CLOSUR1/2021_F_MEDScar/README.md

# 2021_F_MEDScar
2021年全国大学生电子设计大赛F题智能送药小车
