CLOSUR1/2021_F_MEDScar/流程图/openmv巡线.png

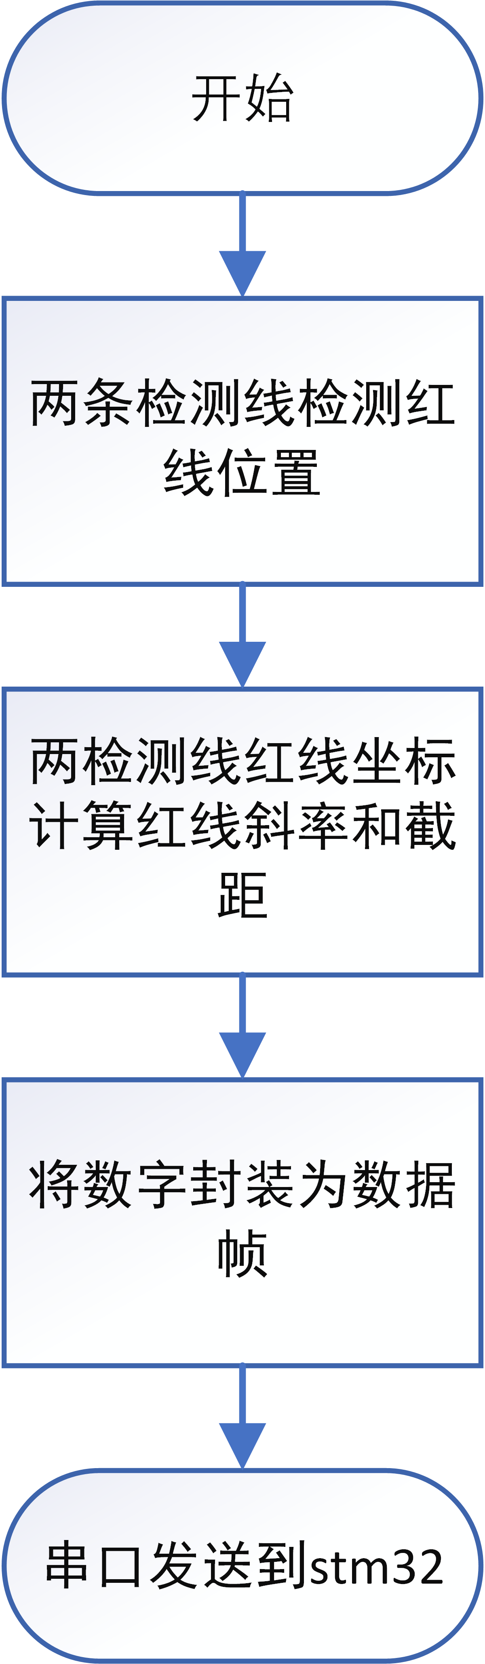
流程图/openmv巡线.png
