CLOSUR1/2021_F_MEDScar/流程图/openmv识别数字.png

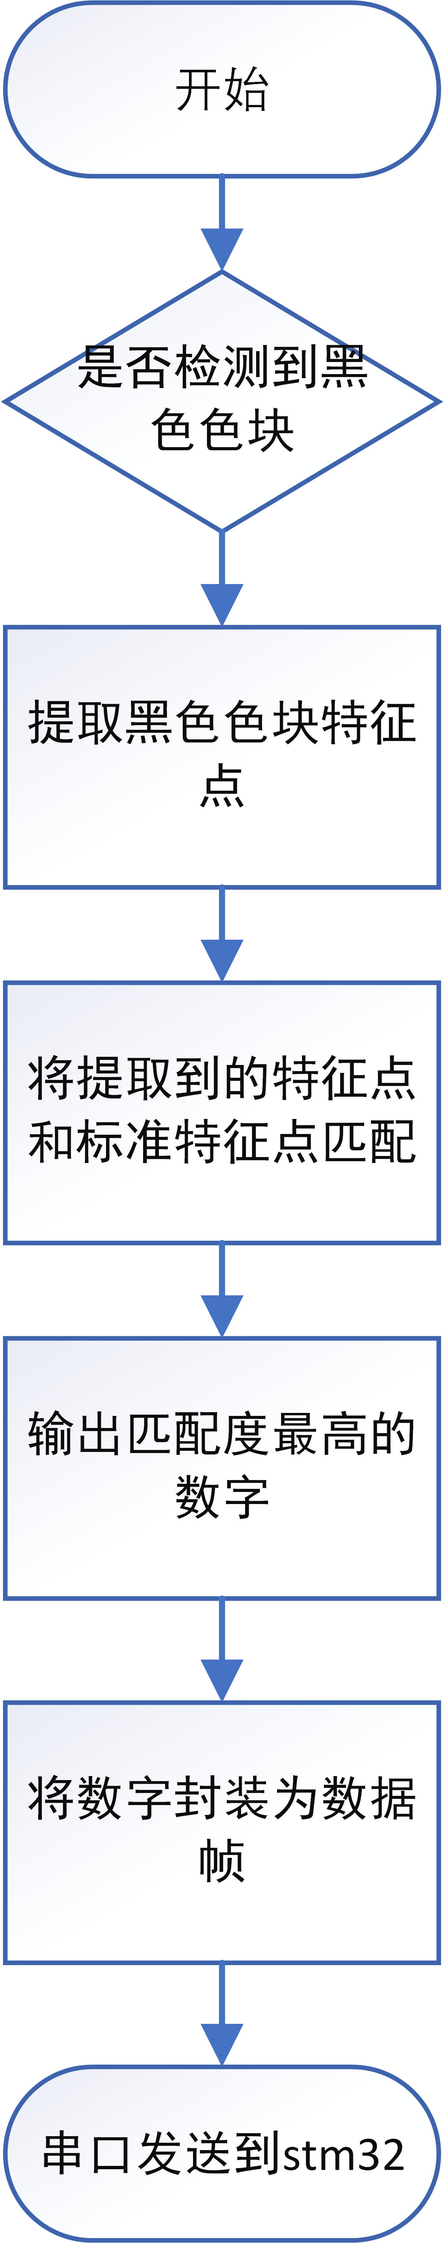
流程图/openmv识别数字.png
