CLOSUR1/2021_F_MEDScar/流程图/主程序.png

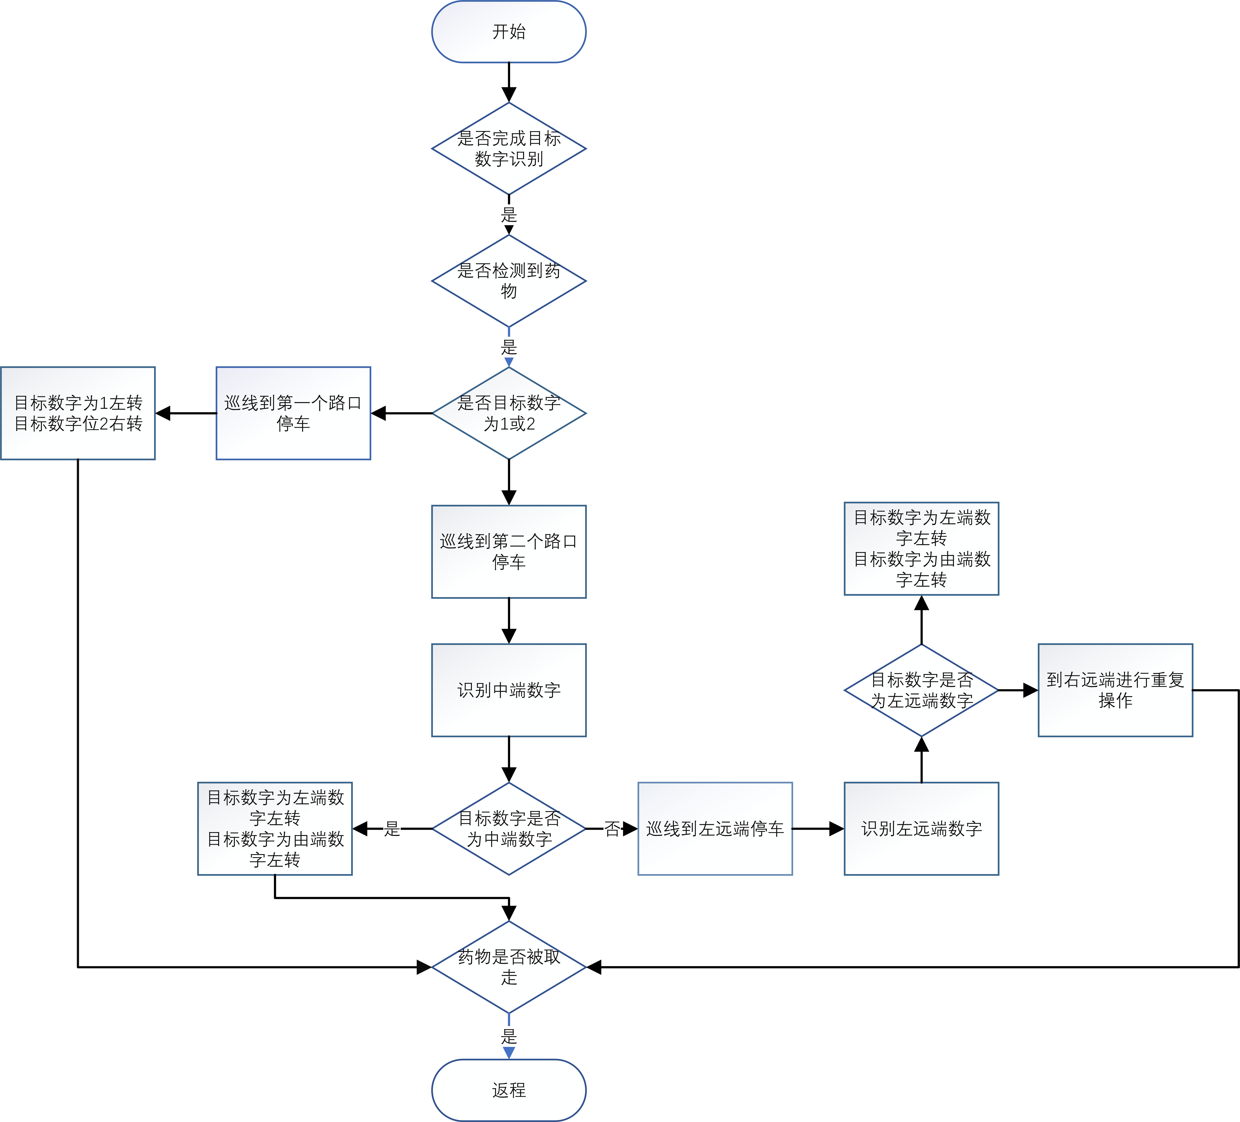
流程图/主程序.png
