CLOSUR1/2021_F_MEDScar/流程图/巡线PID.png

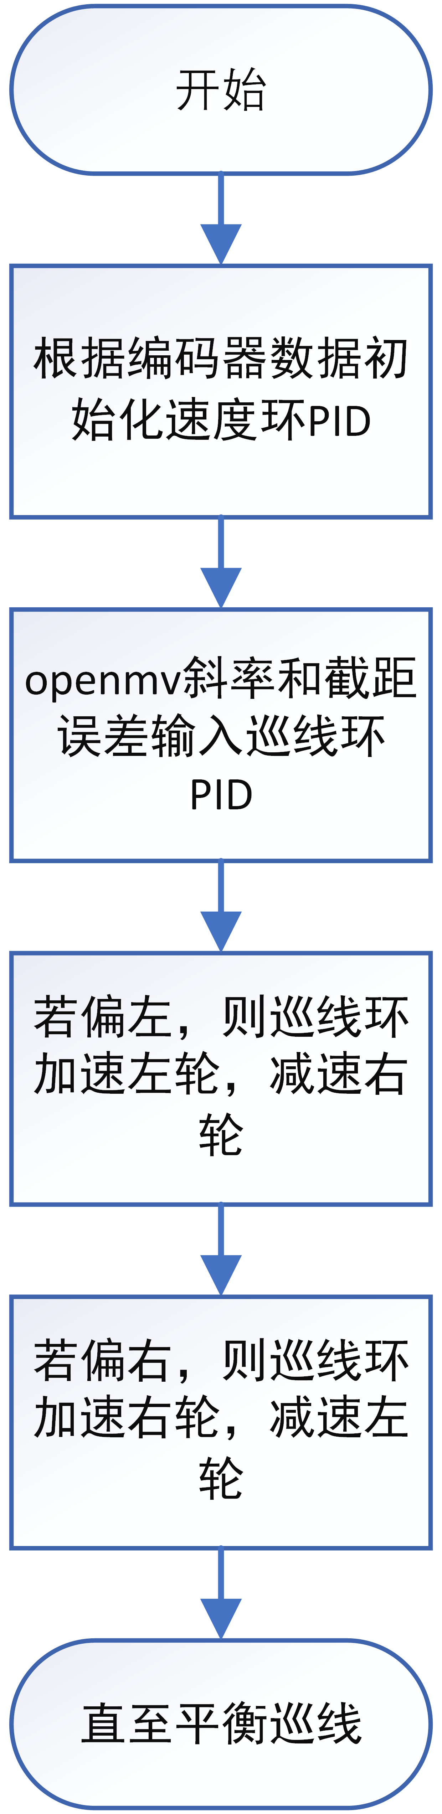
流程图/巡线PID.png
