CLOSUR1/2021_F_MEDScar/流程图/电机驱动.png

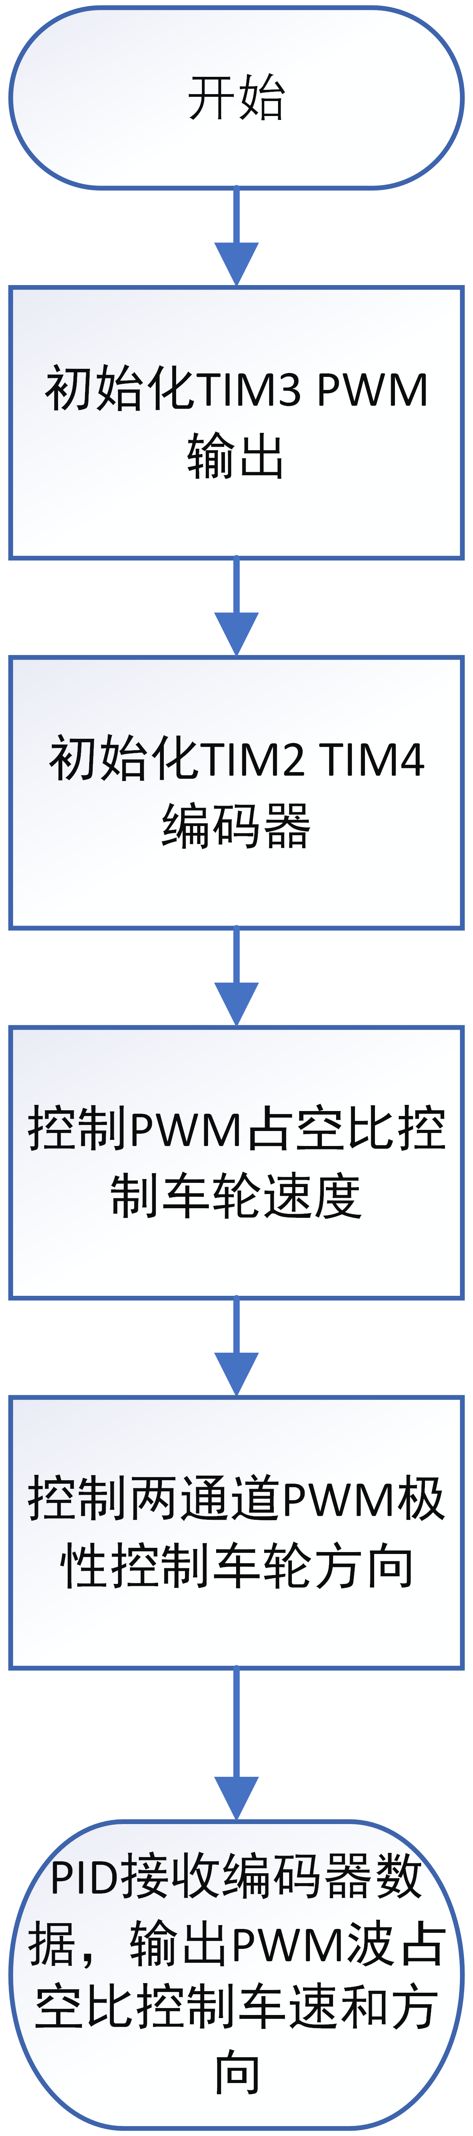
流程图/电机驱动.png
