CLOSUR1/2021_F_MEDScar/流程图/超声识别.png

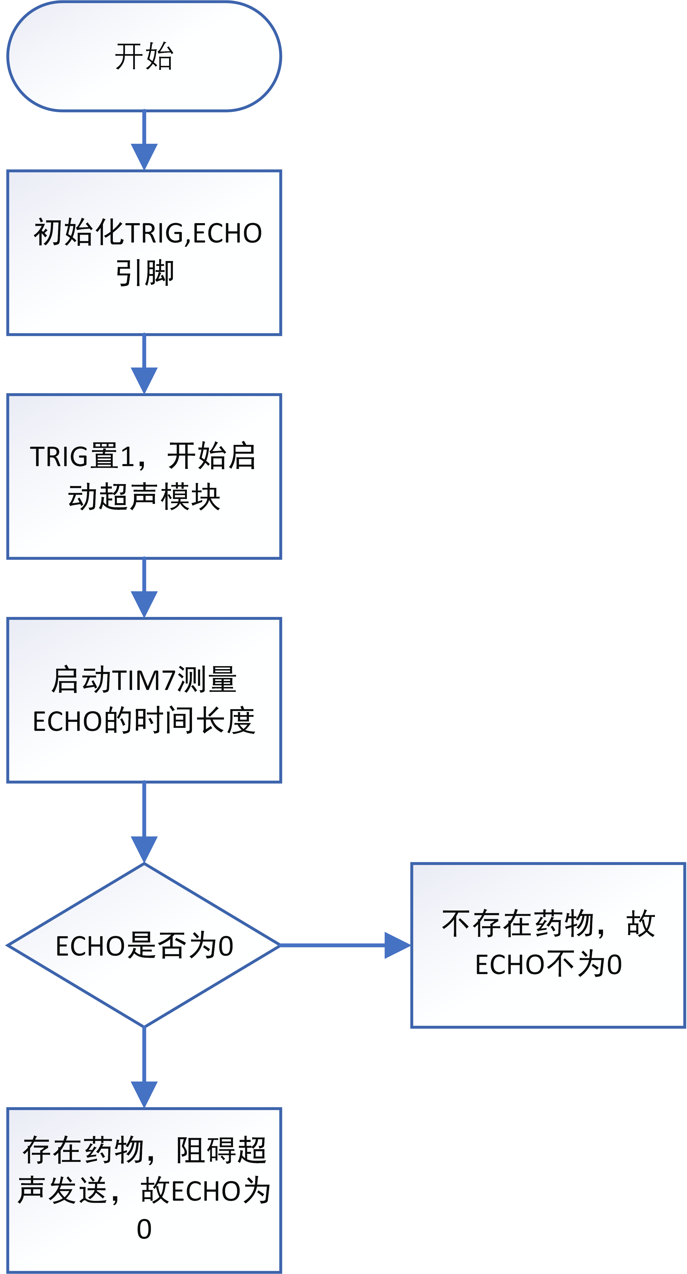
流程图/超声识别.png
