CLOSUR1/2021_F_MEDScar/(list of files, drawings)

Other design files:
PCB/上底板/PCB_上底板.pcbdoc
PCB/上底板/原理图_上底板.schdoc
PCB/车架/车架.pcbdoc
PCB/车架/车架.schdoc
PCB/车身/车身411.pcbdoc
PCB/车身/车身411.schdoc
