CLOSUR1/2021_F_MEDScar/代码合集/STM32F411主控/HARDWARE/LED/led.c

#include "led.h" 
#include "delay.h"

void LED_Init(void)
{    	 
  GPIO_InitTypeDef  GPIO_InitStructure;

  RCC_AHB1PeriphClockCmd(RCC_AHB1Periph_GPIOC, ENABLE);//使能GPIOF时钟

  GPIO_InitStructure.GPIO_Pin = GPIO_Pin_13;//LED0和LED1对应IO口
  GPIO_InitStructure.GPIO_Mode = GPIO_Mode_OUT;//普通输出模式
  GPIO_InitStructure.GPIO_OType = GPIO_OType_PP;//推挽输出
  GPIO_InitStructure.GPIO_Speed = GPIO_Speed_100MHz;//100MHz
  GPIO_InitStructure.GPIO_PuPd = GPIO_PuPd_UP;//上拉
  GPIO_Init(GPIOC, &GPIO_InitStructure);//初始化GPIO
	
	LED=0;
}


//void RGBLED_Init(void)
//{    	 
//  GPIO_InitTypeDef  GPIO_InitStructure;

//  RCC_AHB1PeriphClockCmd(RCC_AHB1Periph_GPIOC, ENABLE);//使能GPIOF时钟

//  GPIO_InitStructure.GPIO_Pin = GPIO_Pin_14|GPIO_Pin_15;//LED0和LED1对应IO口
//  GPIO_InitStructure.GPIO_Mode = GPIO_Mode_OUT;//普通输出模式
//  GPIO_InitStructure.GPIO_OType = GPIO_OType_PP;//推挽输出
//  GPIO_InitStructure.GPIO_Speed = GPIO_Speed_100MHz;//100MHz
//  GPIO_InitStructure.GPIO_PuPd = GPIO_PuPd_UP;//上拉
//  GPIO_Init(GPIOC, &GPIO_InitStructure);//初始化GPIO
//	
//	GLED=1;
//	RLED=0;
//}


void RGBLED_Init(void)
{    	 
  GPIO_InitTypeDef  GPIO_InitStructure;

  RCC_AHB1PeriphClockCmd(RCC_AHB1Periph_GPIOB, ENABLE);//使能GPIOB时钟

  GPIO_InitStructure.GPIO_Pin = GPIO_Pin_12|GPIO_Pin_13;//LED0和LED1对应IO口
  GPIO_InitStructure.GPIO_Mode = GPIO_Mode_OUT;//普通输出模式
  GPIO_InitStructure.GPIO_OType = GPIO_OType_PP;//推挽输出
  GPIO_InitStructure.GPIO_Speed = GPIO_Speed_100MHz;//100MHz
  GPIO_InitStructure.GPIO_PuPd = GPIO_PuPd_UP;//上拉
  GPIO_Init(GPIOB, &GPIO_InitStructure);//初始化GPIO
	
	GLED=1;
	RLED=0;
}



void BEEP_Init(void)
{
	 GPIO_InitTypeDef  GPIO_InitStructure;

  RCC_AHB1PeriphClockCmd(RCC_AHB1Periph_GPIOB, ENABLE);//使能GPIOF时钟

  GPIO_InitStructure.GPIO_Pin = GPIO_Pin_13;//LED0和LED1对应IO口
  GPIO_InitStructure.GPIO_Mode = GPIO_Mode_OUT;//普通输出模式
  GPIO_InitStructure.GPIO_OType = GPIO_OType_PP;//推挽输出
  GPIO_InitStructure.GPIO_Speed = GPIO_Speed_100MHz;//100MHz
  GPIO_InitStructure.GPIO_PuPd = GPIO_PuPd_UP;//上拉
  GPIO_Init(GPIOB, &GPIO_InitStructure);//初始化GPIO
	
	BEEP=0;
	
}




void LED_Flightblink(void)
{
	   LED=0;			  //LED0亮

		 delay_ms(500);
		 LED=1;				//LED0灭

		 delay_ms(500);
        
        
     LED=0;			  //LED0亮

		 delay_ms(50);
		 LED=1;				//LED0灭

		 delay_ms(50);
     LED=0;			  //LED0亮

		 delay_ms(50);
	
		 LED=1;				//LED0灭

		 delay_ms(50);
	
}
