CLOSUR1/2021_F_MEDScar/代码合集/STM32F411主控/USER/hcsr.c

#include "hcsr.h"
#include "syslib.h"

#define TRIG PBout(8)
#define ECHO PAin(5)

void HW_Init(void)
{
	GPIO_InitTypeDef GPIO_InitStruct;
	RCC_AHB1PeriphClockCmd(RCC_AHB1Periph_GPIOA,ENABLE);

	GPIO_InitStruct.GPIO_Speed	= GPIO_Speed_50MHz;			
	GPIO_InitStruct.GPIO_Pin	= GPIO_Pin_5;			
	GPIO_InitStruct.GPIO_Mode	= GPIO_Mode_IN;				
	GPIO_InitStruct.GPIO_PuPd	= GPIO_PuPd_DOWN;		
	GPIO_Init(GPIOA, &GPIO_InitStruct);	
}

void PUT_TEST_HW(void)
{
	int count1=0;
	int n=3;
	if(PUT_TEST_FLAG==1)
	{
		for (int i=0;i<n;i++)
		{
			if(ECHO==1) count1++;
//			printfloat(ECHO);
			delay_ms(100);
		}
	
		if(PUT_TARGET==1)
		{
			if(count1==n) PUT_FLAG=1;
		}
		
		if(PUT_TARGET==0)
		{
			if(count1==0) PUT_FLAG=0;
		}
	}
	else if(PUT_TEST_FLAG==0)
	{
		PUT_FLAG=2;
	}
}

void HCSR_Init(void)
{
	
	GPIO_InitTypeDef GPIO_InitStruct;
	RCC_AHB1PeriphClockCmd(RCC_AHB1Periph_GPIOB,ENABLE);

	GPIO_InitStruct.GPIO_Pin	= GPIO_Pin_8;			
	GPIO_InitStruct.GPIO_Mode	= GPIO_Mode_OUT;		
	GPIO_InitStruct.GPIO_OType	= GPIO_OType_PP;	
	GPIO_InitStruct.GPIO_Speed	= GPIO_Speed_50MHz;		
	GPIO_InitStruct.GPIO_PuPd	= GPIO_PuPd_UP;
	GPIO_Init(GPIOB, &GPIO_InitStruct);
	
	GPIO_InitStruct.GPIO_Pin	= GPIO_Pin_9;			
	GPIO_InitStruct.GPIO_Mode	= GPIO_Mode_IN;				
	GPIO_InitStruct.GPIO_PuPd	= GPIO_PuPd_NOPULL;		
	GPIO_Init(GPIOB, &GPIO_InitStruct);	

	TIM11_IRQ_Init(0.1);
}

int HCSR_GetDis(void)
{
	int t = 0;
	int distance;
	int count = 0;
	
	TRIG=0;
	delay_us(5);
	TRIG=1;
	delay_us(10);
	TRIG=0;

	TIM11->CNT = 0;
	
	while( ECHO == 0)
	{
		t++;
//		delay_us(10);
	
		if(t>= 50000*3)
			return 0;
	}

	TIM_Cmd(TIM11, ENABLE);	
	
	t=0;

	while(ECHO== 1)
	{
		t++;
//		delay_us(20);
	
		if(t >= 120000*3)
			return 0;		
	}

	count = TIM11->CNT;
	
	TIM_Cmd(TIM11, DISABLE);	
	
	distance = count/1;

	return distance;

}

int PUT_FLAG=0;
int PUT_TEST_FLAG=0;
int PUT_TARGET=2;
int d[10];

int sq(int a[],int n) //相似数检测，当有药物时，数据为±3以内波动的数列
{
	int sq=0;
	for (int i=0;i<n;i++)
	{
		if(a[0]-a[i]>=-1&&a[0]-a[i]<=1)
			sq++;
	}
	return sq;
}

int K[3];
void PUT_TEST(void)
{
	int n=5;
	if(PUT_TEST_FLAG==1)
	{
		for (int i=0;i<n;i++)
		{
			int len=HCSR_GetDis();
			d[i]=len;
			delay_ms(100);
			printfloat(len);
		}
		
		K[2]=K[1]; //轮询检测三次
		K[1]=K[0];
		K[0]=sq(d,n);

//		printfloat(K[0]);
		if(PUT_TARGET==1)
		{
			if(K[0]==n&&K[1]==n&&K[2]==n) PUT_FLAG=1;
		}
		
		if(PUT_TARGET==0)
		{
			if(K[0]!=n&&K[1]!=n&&K[2]!=n&&K[0]!=0&&K[1]!=0&&K[2]!=0) PUT_FLAG=0;
		}
	}
	else if(PUT_TEST_FLAG==0)
	{
		PUT_FLAG=2;
		K[2]=0;
		K[1]=0;
		K[0]=0;
	}
}

void HCSR_TEST(void)
{
	PUT_TEST_FLAG=1;
	PUT_TEST();
	if(PUT_FLAG==PUT_TARGET){ GLED=PUT_TARGET;PUT_TARGET=~PUT_TARGET;}
}

void TIM11_IRQ_CallBack(void)
{
	
}


void TIM1_TRG_COM_TIM11_IRQHandler(void)   //TIM11中断
{
	if (TIM_GetITStatus(TIM11, TIM_IT_Update) != RESET)  
		{
		  TIM_ClearITPendingBit(TIM11, TIM_IT_Update); 
			TIM11_IRQ_CallBack();	     
	  }
}

void TIM11_IRQ_Init(float TT)
{
  TIM_TimeBaseInitTypeDef  TIM_TimeBaseStructure;

	RCC_APB2PeriphClockCmd(RCC_APB2Periph_TIM11, ENABLE); //时钟使能
	
	//定时器TIM11初始化
	TIM_TimeBaseStructure.TIM_Period = TT*1000-1; //设置在下一个更新事件装入活动的自动重装载寄存器周期的值	
	TIM_TimeBaseStructure.TIM_Prescaler =84-1; //设置用来作为TIMx时钟频率除数的预分频值
	TIM_TimeBaseStructure.TIM_ClockDivision = TIM_CKD_DIV1; //设置时钟分割:TDTS = Tck_tim
	TIM_TimeBaseStructure.TIM_CounterMode = TIM_CounterMode_Up;  //TIM向上计数模式
	TIM_TimeBaseInit(TIM11, &TIM_TimeBaseStructure); //根据指定的参数初始化TIMx的时间基数单位
 
  TIM_ITConfig(TIM11,TIM_IT_Update,ENABLE ); //使能指定的TIM11计数,允许更新中断

	TIM_Cmd(TIM11, DISABLE);  //关闭TIM11					 
}
