CLOSUR1/2021_F_MEDScar/代码合集/STM32F411主控/USER/adc.c

#include "adc.h"
#include "delay.h"		 
#include "led.h"
#include "syslib.h"

//初始化ADC															   
void  ADC15_Init(void)
{    
  GPIO_InitTypeDef  GPIO_InitStructure;
	ADC_CommonInitTypeDef ADC_CommonInitStructure;
	ADC_InitTypeDef       ADC_InitStructure;
	
  RCC_AHB1PeriphClockCmd(RCC_AHB1Periph_GPIOA, ENABLE);//使能GPIOA时钟
  RCC_APB2PeriphClockCmd(RCC_APB2Periph_ADC1, ENABLE); //使能ADC1时钟

  //先初始化ADC1通道5 IO口
  GPIO_InitStructure.GPIO_Pin = GPIO_Pin_5;//PA5 通道5
  GPIO_InitStructure.GPIO_Mode = GPIO_Mode_AN;//模拟输入
  GPIO_InitStructure.GPIO_PuPd = GPIO_PuPd_NOPULL ;//不带上下拉
  GPIO_Init(GPIOA, &GPIO_InitStructure);//初始化  
 
	RCC_APB2PeriphResetCmd(RCC_APB2Periph_ADC1,ENABLE);	  //ADC1复位
	RCC_APB2PeriphResetCmd(RCC_APB2Periph_ADC1,DISABLE);	//复位结束	 
 
	
  ADC_CommonInitStructure.ADC_Mode = ADC_Mode_Independent;//独立模式
  ADC_CommonInitStructure.ADC_TwoSamplingDelay = ADC_TwoSamplingDelay_5Cycles;//两个采样阶段之间的延迟5个时钟
  ADC_CommonInitStructure.ADC_DMAAccessMode = ADC_DMAAccessMode_Disabled; //DMA失能
  ADC_CommonInitStructure.ADC_Prescaler = ADC_Prescaler_Div4;//预分频4分频。ADCCLK=PCLK2/4=84/4=21Mhz,ADC时钟最好不要超过36Mhz 
  ADC_CommonInit(&ADC_CommonInitStructure);//初始化
	
  ADC_InitStructure.ADC_Resolution = ADC_Resolution_12b;//12位模式
  ADC_InitStructure.ADC_ScanConvMode = DISABLE;//非扫描模式	
  ADC_InitStructure.ADC_ContinuousConvMode = DISABLE;//关闭连续转换
  ADC_InitStructure.ADC_ExternalTrigConvEdge = ADC_ExternalTrigConvEdge_None;//禁止触发检测，使用软件触发
  ADC_InitStructure.ADC_DataAlign = ADC_DataAlign_Right;//右对齐	
  ADC_InitStructure.ADC_NbrOfConversion = 1;//1个转换在规则序列中 也就是只转换规则序列1 
  ADC_Init(ADC1, &ADC_InitStructure);//ADC初始化
	
 
	ADC_Cmd(ADC1, ENABLE);//开启AD转换器	

}				  

u16 Get_Adc(u8 ch)   
{
	  	
	ADC_RegularChannelConfig(ADC1, ch, 1, ADC_SampleTime_3Cycles );	     
	ADC_SoftwareStartConv(ADC1);		//使能指定的ADC1的软件转换启动功能	
	 
	while(!ADC_GetFlagStatus(ADC1, ADC_FLAG_EOC ));//等待转换结束
	return ADC_GetConversionValue(ADC1);	//返回最近一次ADC1规则组的转换结果
}

u16 Get_Adc_Average(u8 ch,u8 times)
{
	u32 temp_val=0;
	u8 t;
	for(t=0;t<times;t++)
	{
		temp_val+=Get_Adc(ch);
		delay_ms(5);
	}
	return temp_val/times;
} 
	 
float ADC15_getu(u8 times)
{
		u16 adcx=Get_Adc_Average(ADC_Channel_5,times);
	  return (float)adcx*(3.3/4096);
}

float DRUGZ_TEST_VOL;
int HEAVY_FLAG=-1;
	
//int HEAVY(void)
//{
//	float value=ADC15_getu(1);
////	printfloat(value);
//	if(value>=0.9f)
//	{
//		return 0;
//	}
//	else
//	{
//	  return 1;
//	}
//}


//void PUT_TEST(void)
//{
//	if(HEAVY()==1)
//			HEAVY_FLAG=0;
//	else
//			HEAVY_FLAG=1;
//}
