CLOSUR1/2021_F_MEDScar/代码合集/STM32F411主控/USER/adc.h

#ifndef __ADC_H
#define __ADC_H	
#include "sys.h" 

void ADC15_Init(void); 				//ADC通道初始化
u16  Get_Adc(u8 ch); 				//获得某个通道值 
u16 Get_Adc_Average(u8 ch,u8 times);//得到某个通道给定次数采样的平均值  

float ADC15_getu(u8 times);
int HEAVY(void);

//extern float DRUGZ_TEST_VOL;
//extern int HEAVY_FLAG;
//void PUT_TEST(void);

#endif 
