CLOSUR1/2021_F_MEDScar/代码合集/STM32F411主控/USER/usart6.c

#include "usart6.h"
#include "syslib.h"
#include "uart_parse.h"

////////////////////////////////////////////////////////////////////////////////// 	 
//如果使用ucos,则包括下面的头文件即可.
#if SYSTEM_SUPPORT_OS
#include "includes.h"					//ucos 使用	  
#endif



void uart6_init(u32 bound){
   //GPIO端口设置
 GPIO_InitTypeDef GPIO_InitStructure;
	USART_InitTypeDef USART_InitStructure;
	NVIC_InitTypeDef NVIC_InitStructure;
	
	RCC_AHB1PeriphClockCmd(RCC_AHB1Periph_GPIOA,ENABLE); //使能GPIOA时钟
	RCC_APB2PeriphClockCmd(RCC_APB2Periph_USART6,ENABLE);//使能USART1时钟
 
	//串口1对应引脚复用映射
	GPIO_PinAFConfig(GPIOA,GPIO_PinSource11,GPIO_AF_USART6); //GPIOA9复用为USART1
	GPIO_PinAFConfig(GPIOA,GPIO_PinSource12,GPIO_AF_USART6); //GPIOA10复用为USART1
	
	//USART1端口配置
  GPIO_InitStructure.GPIO_Pin = GPIO_Pin_11 | GPIO_Pin_12; //GPIOA9与GPIOA10
	GPIO_InitStructure.GPIO_Mode = GPIO_Mode_AF;//复用功能
	GPIO_InitStructure.GPIO_Speed = GPIO_Speed_50MHz;	//速度50MHz
	GPIO_InitStructure.GPIO_OType = GPIO_OType_PP; //推挽复用输出
	GPIO_InitStructure.GPIO_PuPd = GPIO_PuPd_UP; //上拉
	GPIO_Init(GPIOA,&GPIO_InitStructure); //初始化PA9，PA10

   //USART1 初始化设置
	USART_InitStructure.USART_BaudRate = bound;//波特率设置
	USART_InitStructure.USART_WordLength = USART_WordLength_8b;//字长为8位数据格式
	USART_InitStructure.USART_StopBits = USART_StopBits_1;//一个停止位
	USART_InitStructure.USART_Parity = USART_Parity_No;//无奇偶校验位
	USART_InitStructure.USART_HardwareFlowControl = USART_HardwareFlowControl_None;//无硬件数据流控制
	USART_InitStructure.USART_Mode = USART_Mode_Rx ;	//收发模式
  USART_Init(USART6, &USART_InitStructure); //初始化串口1
	
  USART_Cmd(USART6, ENABLE);  //使能串口1 
	
	USART_ITConfig(USART6, USART_IT_RXNE, ENABLE);//开启相关中断

  NVIC_InitStructure.NVIC_IRQChannel = USART6_IRQn;//串口1中断通道
	NVIC_InitStructure.NVIC_IRQChannelPreemptionPriority=1;//抢占优先级3
	NVIC_InitStructure.NVIC_IRQChannelSubPriority =3;		//子优先级3
	NVIC_InitStructure.NVIC_IRQChannelCmd = ENABLE;			//IRQ通道使能
	NVIC_Init(&NVIC_InitStructure);	//根据指定的参数初始化VIC寄存器、
	
}

u8 USART_RX_BUF6[USART_REC_LEN6];     
u16 USART6_RX_STA=0;  

int uart6_res_flag=0;
float u6[3];

int U6COUNT;

void USART6_IRQHandler(void)                	//串口1中断服务程序
	{
#if SYSTEM_SUPPORT_OS 		//如果SYSTEM_SUPPORT_OS为真，则需要支持OS.
	OSIntEnter();    
#endif
		
			u8 Res = USART_ReceiveData(USART6);
			if(Res=='d')
				uart6_res_flag=1;
			if(uart6_res_flag==1)
		  	USART_RX_BUF6[USART6_RX_STA++] = Res;  		 
			if(uart6_res_flag==1&&Res=='m')
			{ 		
    		VL53L0_parse((char*)USART_RX_BUF6,u6);
				uart6_res_flag=0;
				USART6_RX_STA=0;				
		  }		
		
#if SYSTEM_SUPPORT_OS 	//如果SYSTEM_SUPPORT_OS为真，则需要支持OS.
	OSIntExit();  											 
#endif
 } 
	
