CLOSUR1/2021_F_MEDScar/代码合集/STM32F411主控/USER/usart6.h

#ifndef __USART6_H
#define __USART6_H
#include "stdio.h"	
#include "stm32f4xx_conf.h"
#include "sys.h" 


#define USART_REC_LEN6 			100  	//定义最大接收字节数 200
#define EN_USART6_RX 			1		//使能（1）/禁止（0）串口1接收
	  	

void uart6_init(u32 bound);
extern float u6[3];
//extern int U6COUNT;
#endif
