CLOSUR1/2021_F_MEDScar/(commit log)

2023-10-06 单OpenMV实现
    [PCB_上底板.pcbdoc, 原理图_上底板.schdoc, 车架.pcbdoc, 车架.schdoc, 车身411.pcbdoc, 车身411.schdoc]
2025-05-14 更新硬件清单
